jasonleelunn/Arduino-Stepper-Motor-LCD-Control-Project/IRTest/Button_Values.ino

//* NEC IR Controller Hexadecimal Button Values *//

          // POWER            = FD00FF
          // FUNC/STOP        = FD40BF
          // VOL+             = FD807F
          // VOL-             = FD906F
          // RIGHT            = FD609F
          // LEFT             = FD20DF
          // PLAY             = FDA05F
          // UP               = FD50AF
          // DOWN             = FD10EF
          // EQ               = FDB04F
          // ST/REPT          = FD708F
          // 0                = FD30CF
          // 1                = FD08F7
          // 2                = FD8877
          // 3                = FD48B7
          // 4                = FD28D7
          // 5                = FDA857
          // 6                = FD6897
          // 7                = FD18E7
          // 8                = FD9867
          // 9                = FD58A7
